Farhad-Ebrahimi/NOVACore/src/pp_alu_control_unit.vhd

-- The NOVACore - A 7-stage in-order RISC-V processor for FPGAs
-- (c) Farhad EbrahimiAzandaryani 2023-2024 <farhad.ebrahimiazandaryani@fau.de>
-- Demonstration : <https://www.cs3.tf.fau.de/nova-core-2/>
-- Report bugs and issues on <https://github.com/Farhad-Ebrahimi/NOVACore/issues>

-- Based on:
-- The Potato Processor - A simple processor for FPGAs
-- (c) Kristian Klomsten Skordal 2014 - 2015 <kristian.skordal@wafflemail.net>
-- Report bugs and issues on <https://github.com/skordal/potato/issues>


library ieee;
use ieee.std_logic_1164.all;

use work.pp_types.all;
use work.pp_constants.all;

entity pp_alu_control_unit is
	port(
		opcode  : in std_logic_vector( 4 downto 0);
		funct3  : in std_logic_vector( 2 downto 0);
		funct7  : in std_logic_vector( 6 downto 0);
		rs2     : in std_logic_vector( 4 downto 0);  -- rs2 field to distinguish FCVT variants
		
		-- Sources of ALU operands:
		alu_x_src, alu_y_src : out alu_operand_source;

		-- ALU operation:
		alu_op : out alu_operation
	);
end entity pp_alu_control_unit;

architecture behaviour of pp_alu_control_unit is
begin

	decode_alu: process(opcode, funct3, funct7, rs2)
	begin
		case opcode is
			when b"01101" => -- Load upper immediate
				alu_x_src <= ALU_SRC_NULL;
				alu_y_src <= ALU_SRC_IMM;
				alu_op <= ALU_ADD;
			when b"00101" => -- Add upper immediate to PC
				alu_x_src <= ALU_SRC_PC;
				alu_y_src <= ALU_SRC_IMM;
				alu_op <= ALU_ADD;
			when b"11011" => -- Jump and link
				alu_x_src <= ALU_SRC_PC_NEXT;
				alu_y_src <= ALU_SRC_NULL;
				alu_op <= ALU_ADD;
			when b"11001" => -- Jump and link register
				alu_x_src <= ALU_SRC_PC_NEXT;
				alu_y_src <= ALU_SRC_NULL;
				alu_op <= ALU_ADD;
			when b"11000" => -- Branch operations
				-- The funct3 field decides which type of branch comparison is
				-- done; this is decoded in the branch comparator module.
				alu_x_src <= ALU_SRC_NULL;
				alu_y_src <= ALU_SRC_NULL;
				alu_op <= ALU_NOP;
			when b"00000" => -- Load instruction
				alu_x_src <= ALU_SRC_REG;
				alu_y_src <= ALU_SRC_IMM;
				alu_op <= ALU_ADD;
			when b"01000" => -- Store instruction
				alu_x_src <= ALU_SRC_REG;
				alu_y_src <= ALU_SRC_IMM;
				alu_op <= ALU_ADD;
			when b"00100" => -- Register-immediate operations
				alu_x_src <= ALU_SRC_REG;

				if funct3 = b"001" or funct3 = b"101" then
					alu_y_src <= ALU_SRC_SHAMT;
				else
					alu_y_src <= ALU_SRC_IMM;
				end if;

				case funct3 is
					when b"000" =>
						alu_op <= ALU_ADD;
					when b"001" =>
						alu_op <= ALU_SLL;
					when b"010" =>
						alu_op <= ALU_SLT;
					when b"011" =>
						alu_op <= ALU_SLTU;
					when b"100" =>
						alu_op <= ALU_XOR;
					when b"101" =>
						if funct7 = b"0000000" then
							alu_op <= ALU_SRL;
						else
							alu_op <= ALU_SRA;
						end if;
					when b"110" =>
						alu_op <= ALU_OR;
					when b"111" =>
						alu_op <= ALU_AND;
					when others =>
						alu_op <= ALU_INVALID;
				end case; 
			when b"01100" => -- Register-register operations
				alu_x_src <= ALU_SRC_REG;
				alu_y_src <= ALU_SRC_REG;

				case funct3 is
					when b"000" =>
						if funct7 = "0000000" then
                            alu_op <= ALU_ADD;
                        elsif funct7 = "0000001" then
                            alu_op <= ALU_MUL;
                        else
                            alu_op <= ALU_SUB;
                        end if;
					when b"001" =>
						if funct7 = "0000001" then
                            alu_op <= ALU_MULH;
                        else
                            alu_op <= ALU_SLL;
                        end if;
					when b"010" =>
						if funct7 = "0000001" then
                            alu_op <= ALU_MULHSU;
                        else
                            alu_op <= ALU_SLT;
                        end if;
					when b"011" =>
						if funct7 = "0000001" then
                            alu_op <= ALU_MULHU;
                        else
                            alu_op <= ALU_SLTU;
                        end if;
					when b"100" =>
            if funct7 = "0000000" then
              alu_op <= ALU_XOR;
            else
              alu_op <= ALU_DIV;
            end if;
					when b"101" =>
						if funct7 = b"0000000" then
							alu_op <= ALU_SRL;
            elsif funct7 = b"0100000" then
							alu_op <= ALU_SRA;
            else
              alu_op <= ALU_DIVU;
						end if;
					when b"110" =>
						alu_op <= ALU_OR;
					when b"111" =>
						alu_op <= ALU_AND;
					when others =>
						alu_op <= ALU_INVALID;
				end case;
			when b"00011" => -- Fence instructions, ignored
				alu_x_src <= ALU_SRC_REG;
				alu_y_src <= ALU_SRC_REG;
				alu_op <= ALU_NOP;
			when b"11100" => -- System instructions
				alu_x_src <= ALU_SRC_CSR;
				alu_y_src <= ALU_SRC_NULL;
				alu_op <= ALU_ADD;
			when b"10100" => -- Floating-point operations (opcode 0x53) ----fpu 2025
				alu_x_src <= ALU_SRC_REG;
				alu_y_src <= ALU_SRC_REG;
				
				case funct7 is  ----fpu 2025
					when b"0000000" =>
						alu_op <= ALU_FADD;  	----fpu 2025
					when b"0000100" =>
						alu_op <= ALU_FSUB;  	----fpu 2025
					when b"0001000" =>
						alu_op <= ALU_FMUL;  	----fpu 2025
					when b"0001100" =>
						alu_op <= ALU_FDIV;  	----fpu 2025
		--Move the single-precision value in floating-point register rs1 
		----represented in IEEE 754-2008 encoding to the lower 32 bits of integer register rd.
					when b"1110000" =>
					     alu_op <= ALU_FMVXW;  	----fpu 2025 (FP register → Integer register) 
					when b"1111000" =>
					     alu_op <= ALU_FMVWX;  	----fpu 2025 (Integer register → FP register)
					when b"1010000" =>
					     alu_op <= ALU_Comp;  	----fpu 2025
						 case funct3 is
							when b"010" =>
								alu_op <= ALU_FEQ;  	----fpu 2025 (FEQ.S)
							when b"001" =>
								alu_op <= ALU_FLT;  	----fpu 2025 (FLT.S)
							when b"000" =>
								alu_op <= ALU_FLE;  	----fpu 2025 (FLE.S)
							when others =>
								alu_op <= ALU_INVALID;
						 end case;
					when b"1100000" =>
					-- FCVT: Check rs2 to distinguish signed vs unsigned
					if rs2 = b"00000" then
						alu_op <= ALU_FCVT_W;   -- FCVT.W.S (FP → signed int)
					elsif rs2 = b"00001" then
						alu_op <= ALU_FCVT_WU;  -- FCVT.WU.S (FP → unsigned int)
					else
						alu_op <= ALU_INVALID;
					end if;				
					when b"1101000" =>
				-- FCVT.S: Check rs2 to distinguish signed vs unsigned (int → FP)
				if rs2 = b"00000" then
					alu_op <= ALU_FCVT_S_W;  -- FCVT.S.W (signed int → FP)
				elsif rs2 = b"00001" then
					alu_op <= ALU_FCVT_S_WU; -- FCVT.S.WU (unsigned int → FP)
				else
					alu_op <= ALU_INVALID;
				end if;					
				when others =>
						alu_op <= ALU_INVALID;
				end case;
			when b"00001" => -- Floating-point load (FLW)
				alu_x_src <= ALU_SRC_REG;
				alu_y_src <= ALU_SRC_IMM;
				
				case funct3 is
					when b"010" =>
						alu_op <= ALU_ADD;  -- Address calculation: base + offset
					when others =>
						alu_op <= ALU_INVALID;
				end case;
			when b"01001" => -- Floating-point Store (FSW)
				alu_x_src <= ALU_SRC_REG;
				alu_y_src <= ALU_SRC_IMM;
				
				case funct3 is
					when b"010" =>
						alu_op <= ALU_ADD;  -- Address calculation: base + offset
					when others =>
						alu_op <= ALU_INVALID;
				end case;
			when others =>
				alu_x_src <= ALU_SRC_REG;
				alu_y_src <= ALU_SRC_REG;
				alu_op <= ALU_INVALID;
		end case;
	end process decode_alu;

end architecture behaviour;
