Farhad-Ebrahimi/NOVACore/src/aee_rom.vhd

-- The NOVACore - A 7-stage in-order RISC-V processor for FPGAs
-- (c) Farhad EbrahimiAzandaryani 2023-2024 <farhad.ebrahimiazandaryani@fau.de>
-- Demonstration : <https://www.cs3.tf.fau.de/nova-core-2/>
-- Report bugs and issues on <https://github.com/Farhad-Ebrahimi/NOVACore/issues>

library ieee;
use ieee.std_logic_1164.all;
use ieee.numeric_std.all;

entity fsbl_rom is
  port (
    clka : in std_logic;
    addra : in std_logic_vector(7 downto 0);
    douta : out std_logic_vector(31 downto 0)
  );
end fsbl_rom;

architecture rtl of fsbl_rom is

  type rom_type is array(0 to 255) of std_logic_vector(31 downto 0);

    ---7 => x"A03216D3",

constant rom_memory : rom_type := (

      0 => x"00000097",   1 => x"07408093",   2 => x"30509073",   3 => x"00000097",
      4 => x"2fc08093",   5 => x"00008117",   6 => x"fec10113",   7 => x"00008197",
      8 => x"fe418193",   9 => x"00310c63",  10 => x"00008203",  11 => x"00410023",
     12 => x"00108093",  13 => x"00110113",  14 => x"fe3118e3",  15 => x"00008097",
     16 => x"fc408093",  17 => x"00008117",  18 => x"fc010113",  19 => x"00208863",
     20 => x"0000a023",  21 => x"00408093",  22 => x"fe209ce3",  23 => x"00088117",
     24 => x"fa410113",  25 => x"00000097",  26 => x"190080e7",  27 => x"10500073",
     28 => x"ffdff06f",  29 => x"f8410113",  30 => x"00112023",  31 => x"00212223",
     32 => x"00312423",  33 => x"00412623",  34 => x"00512823",  35 => x"00612a23",
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
    236 => x"4c45530d", 237 => x"20544345", 238 => x"0000203e", 239 => x"550d0a0a",
    240 => x"414f4c50", 241 => x"4e412044", 242 => x"42535320", 243 => x"2e2e2e4c",
    244 => x"000d0a0a", 245 => x"41570d0a", 246 => x"203a4e52", 247 => x"4c425353",
    248 => x"544f4e20", 249 => x"554f4620", 250 => x"0a21444e", 251 => x"0000000d",
    252 => x"4e490d0a", 253 => x"494c4156", 254 => x"0d0a2144", others => x"00000000"
);

begin

  process (clka)
  begin
    if rising_edge(clka) then
      douta <= rom_memory(to_integer(unsigned(addra)));
    end if;
  end process;

end rtl;
