Farhad-Ebrahimi/NOVACore/(commit log)

2024-09-10 To make the design compatible with OpenLane2, all Xilinx IP blocks were replaced with their VHDL counterparts, and some files were slightly modified to be synthesized by GHDL. To clock the design, yo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
    [aee_rom.vhd, mul_stg2.vhd, pp_soc_reset.vhd, pp_wb_adapter.vhd, toplevel.vhd]
2025-02-11 The integration of a 1-bit dynamic branch prediction unit feature is currently in progress.
2025-02-13 Integrated BPU successfully – works seamlessly.
2025-03-03 The First Stage Bootloader (FSBL) is now stored in ROM, while the Second Stage Bootloader (SSBL) is modifiable and can be updated as needed. This change enhances flexibility and allows firmware updat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
2025-03-17 Seamless FSBL- & SSBL-Mem integration with UART0 and UART1 support
2025-05-24 UART works. dubugging is in progress
2025-06-07 Debugging is in progress. writing on UART works properly but reading from UART has problem!
    [nv_memsys.vhd, sram_wrapper_aee_ram.vhd, sram_wrapper_ssbl_ram.vhd]
2025-07-24 AEE-RAM removed; system runs at 166 MHz
2025-07-24 Second UART interface enabled for peripheral expansion
